lunderot/7-seg-array-clock/media/pcb-front.png

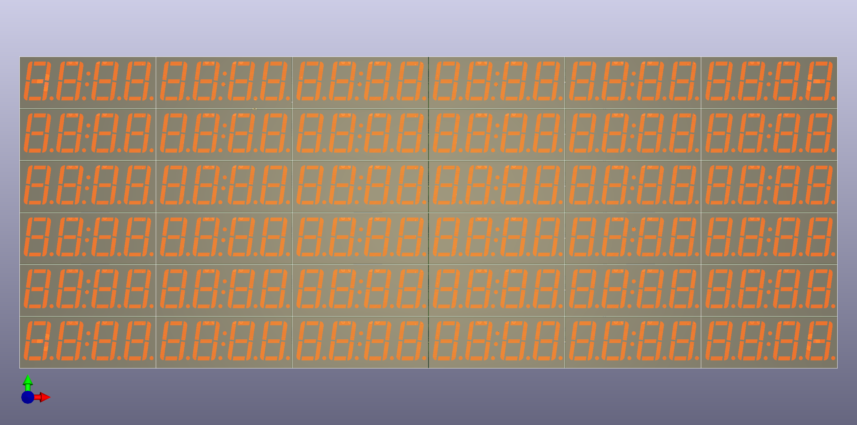
media/pcb-front.png
