lunderot/7-seg-array-clock/README.md

# 7 segment array clock
A clock made of 144 individual 7-segment displays. Uses a ESP8266 and MAX7219.

Finished clock
