lunderot/7-seg-array-clock/media/7-seg-4-digit.png

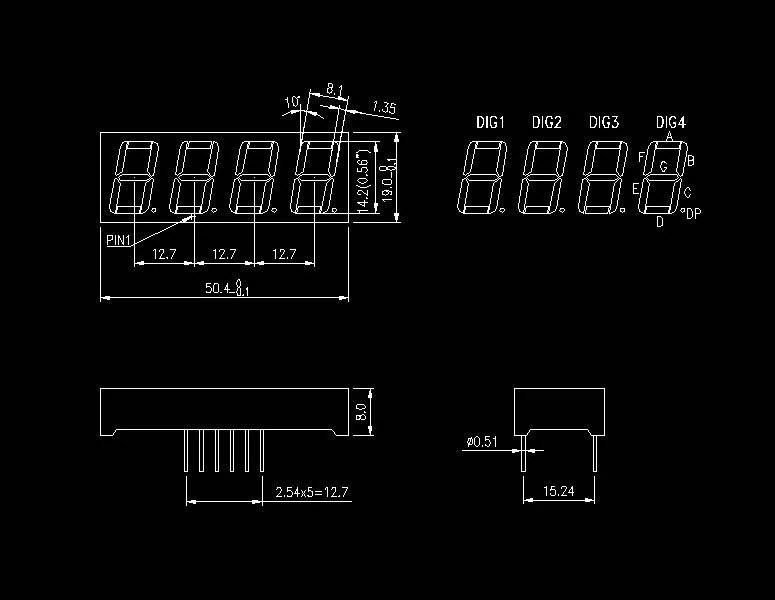
media/7-seg-4-digit.png
