lunderot/7-seg-array-clock/media/pcb-back.png

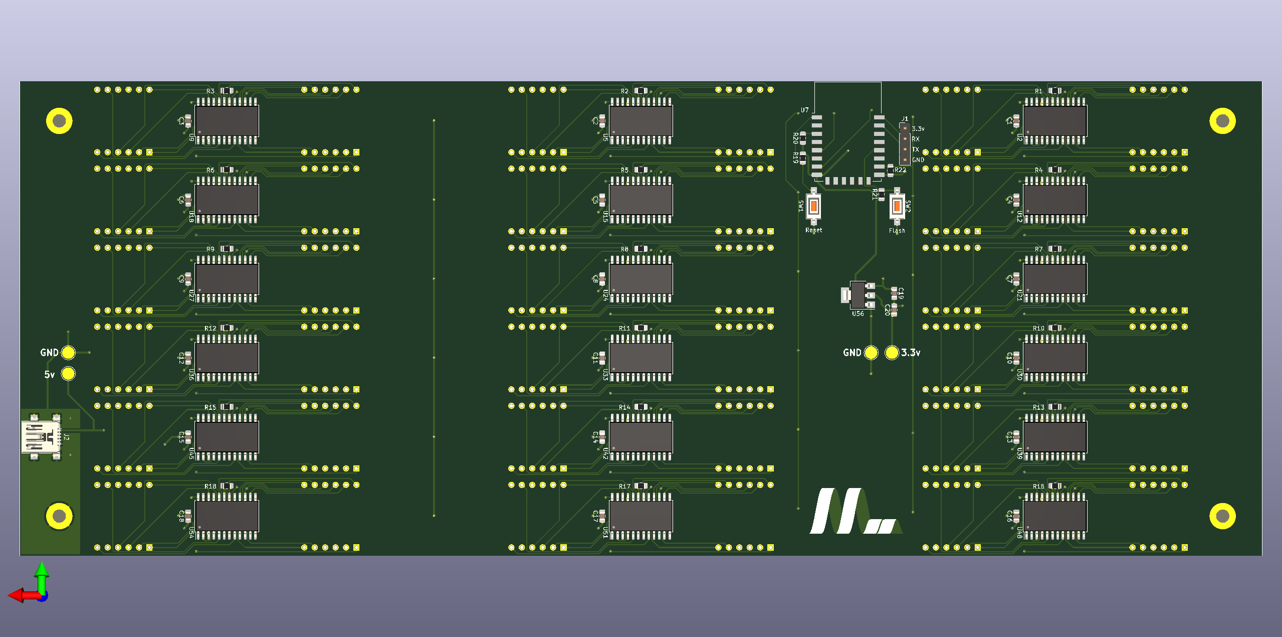
media/pcb-back.png
