lunderot/7-seg-array-clock/circuit/7-seg-array-clock.kicad_pcb

## KiCad design circuit/7-seg-array-clock.kicad_pcb (2020-04-03)

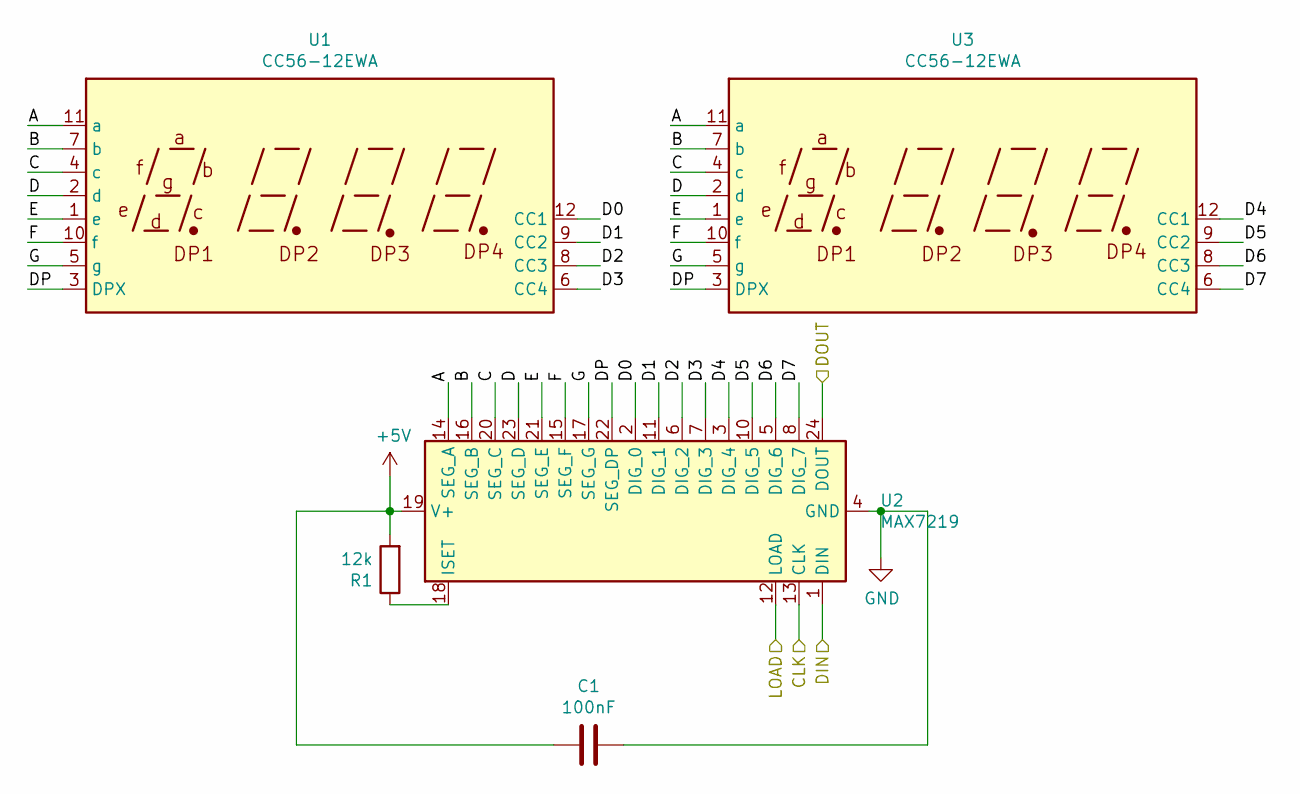
[picture p4: schematic 7-seg-8-dig.sch]

Parts:
C1: 100nF; C_0805_2012Metric_Pad1.15x1.40mm_HandSolder
R1: 12k; R_0805_2012Metric_Pad1.15x1.40mm_HandSolder
U1, U3: CC56-12EWA; 7seg
U2: MAX7219; SOIC-24W_7.5x15.4mm_P1.27mm

Connections:
+5V: C1.2, R1.2, U2.19 (V+); also elsewhere on the board
/display0/A: U1.11 (a), U2.14 (SEG_A), U3.11 (a)
/display0/B: U1.7 (b), U2.16 (SEG_B), U3.7 (b)
/display0/C: U1.4 (c), U2.20 (SEG_C), U3.4 (c)
/display0/D: U1.2 (d), U2.23 (SEG_D), U3.2 (d)
/display0/D0: U1.12 (CC1), U2.2 (DIG_0)
/display0/D1: U1.9 (CC2), U2.11 (DIG_1)
/display0/D2: U1.8 (CC3), U2.6 (DIG_2)
/display0/D3: U1.6 (CC4), U2.7 (DIG_3)
/display0/D4: U2.3 (DIG_4), U3.12 (CC1)
/display0/D5: U2.10 (DIG_5), U3.9 (CC2)
/display0/D6: U2.5 (DIG_6), U3.8 (CC3)
/display0/D7: U2.8 (DIG_7), U3.6 (CC4)
/display0/DIN: U2.1 (DIN); also elsewhere on the board
/display0/DP: U1.3 (DPX), U2.22 (SEG_DP), U3.3 (DPX)
/display0/E: U1.1 (e), U2.21 (SEG_E), U3.1 (e)
/display0/F: U1.10 (f), U2.15 (SEG_F), U3.10 (f)
/display0/G: U1.5 (g), U2.17 (SEG_G), U3.5 (g)
/display1/DIN: U2.24 (DOUT); also elsewhere on the board
CLK: U2.13 (CLK); also elsewhere on the board
GND: C1.1, U2.4 (GND), U2.9 (GND); also elsewhere on the board
LOAD: U2.12 (LOAD); also elsewhere on the board
unnamed: R1.1, U2.18 (ISET)

Parts of its further copies:
C2, C3, C4, C5, C6, C7, C8, C9, C10, C11, C12, C13, C14, C15, C16, C17, C18: 100nF; C_0805_2012Metric_Pad1.15x1.40mm_HandSolder
R2, R3, R4, R5, R6, R7, R8, R9, R10, R11, R12, R13, R14, R15, R16, R17, R18: 12k; R_0805_2012Metric_Pad1.15x1.40mm_HandSolder
U4, U6, U8, U10, U11, U13, U14, U16, U17, U19, U20, U22, U23, U25, U26, U28, U29, U31, U32, U34, U35, U37, U38, U40, U41, U43, U44, U46, U47, U49, U50, U52, U53, U55: CC56-12EWA; 7seg
U5, U9, U12, U15, U18, U21, U24, U27, U30, U33, U36, U39, U42, U45, U48, U51, U54: MAX7219; SOIC-24W_7.5x15.4mm_P1.27mm

Connections of its further copies:
+5V: C2.2, C3.2, C4.2, C5.2, C6.2, C7.2, C8.2, C9.2, C10.2, C11.2, C12.2, C13.2, C14.2, C15.2, C16.2, C17.2, C18.2, R2.2, R3.2, R4.2, R5.2, R6.2, R7.2, R8.2, R9.2, R10.2, R11.2, R12.2, R13.2, R14.2, R15.2, R16.2, R17.2, R18.2, U5.19 (V+), U9.19 (V+), U12.19 (V+), U15.19 (V+), U18.19 (V+), U21.19 (V+), U24.19 (V+), U27.19 (V+), U30.19 (V+), U33.19 (V+), U36.19 (V+), U39.19 (V+), U42.19 (V+), U45.19 (V+), U48.19 (V+), U51.19 (V+), U54.19 (V+); also elsewhere on the board
/display1/A: U4.11 (a), U5.14 (SEG_A), U6.11 (a)
/display1/B: U4.7 (b), U5.16 (SEG_B), U6.7 (b)
/display1/C: U4.4 (c), U5.20 (SEG_C), U6.4 (c)
/display1/D: U4.2 (d), U5.23 (SEG_D), U6.2 (d)
/display1/D0: U4.12 (CC1), U5.2 (DIG_0)
/display1/D1: U4.9 (CC2), U5.11 (DIG_1)
/display1/D2: U4.8 (CC3), U5.6 (DIG_2)
/display1/D3: U4.6 (CC4), U5.7 (DIG_3)
/display1/D4: U5.3 (DIG_4), U6.12 (CC1)
/display1/D5: U5.10 (DIG_5), U6.9 (CC2)
/display1/D6: U5.5 (DIG_6), U6.8 (CC3)
/display1/D7: U5.8 (DIG_7), U6.6 (CC4)
/display1/DIN: U5.1 (DIN); also elsewhere on the board
/display1/DP: U4.3 (DPX), U5.22 (SEG_DP), U6.3 (DPX)
/display1/E: U4.1 (e), U5.21 (SEG_E), U6.1 (e)
/display1/F: U4.10 (f), U5.15 (SEG_F), U6.10 (f)
/display1/G: U4.5 (g), U5.17 (SEG_G), U6.5 (g)
/display3/A: U8.11 (a), U9.14 (SEG_A), U10.11 (a)
/display3/B: U8.7 (b), U9.16 (SEG_B), U10.7 (b)
/display3/C: U8.4 (c), U9.20 (SEG_C), U10.4 (c)
/display3/D: U8.2 (d), U9.23 (SEG_D), U10.2 (d)
/display3/D0: U8.12 (CC1), U9.2 (DIG_0)
/display3/D1: U8.9 (CC2), U9.11 (DIG_1)
/display3/D2: U8.8 (CC3), U9.6 (DIG_2)
/display3/D3: U8.6 (CC4), U9.7 (DIG_3)
/display3/D4: U9.3 (DIG_4), U10.12 (CC1)
/display3/D5: U9.10 (DIG_5), U10.9 (CC2)
/display3/D6: U9.5 (DIG_6), U10.8 (CC3)
/display3/D7: U9.8 (DIG_7), U10.6 (CC4)
/display3/DIN: U5.24 (DOUT), U9.1 (DIN)
/display3/DP: U8.3 (DPX), U9.22 (SEG_DP), U10.3 (DPX)
/display3/E: U8.1 (e), U9.21 (SEG_E), U10.1 (e)
/display3/F: U8.10 (f), U9.15 (SEG_F), U10.10 (f)
/display3/G: U8.5 (g), U9.17 (SEG_G), U10.5 (g)
/display4/A: U11.11 (a), U12.14 (SEG_A), U13.11 (a)
/display4/B: U11.7 (b), U12.16 (SEG_B), U13.7 (b)
/display4/C: U11.4 (c), U12.20 (SEG_C), U13.4 (c)
/display4/D: U11.2 (d), U12.23 (SEG_D), U13.2 (d)
/display4/D0: U11.12 (CC1), U12.2 (DIG_0)
/display4/D1: U11.9 (CC2), U12.11 (DIG_1)
/display4/D2: U11.8 (CC3), U12.6 (DIG_2)
/display4/D3: U11.6 (CC4), U12.7 (DIG_3)
/display4/D4: U12.3 (DIG_4), U13.12 (CC1)
/display4/D5: U12.10 (DIG_5), U13.9 (CC2)
/display4/D6: U12.5 (DIG_6), U13.8 (CC3)
/display4/D7: U12.8 (DIG_7), U13.6 (CC4)
/display4/DIN: U9.24 (DOUT), U12.1 (DIN)
/display4/DP: U11.3 (DPX), U12.22 (SEG_DP), U13.3 (DPX)
/display4/E: U11.1 (e), U12.21 (SEG_E), U13.1 (e)
/display4/F: U11.10 (f), U12.15 (SEG_F), U13.10 (f)
/display4/G: U11.5 (g), U12.17 (SEG_G), U13.5 (g)
/display5/A: U14.11 (a), U15.14 (SEG_A), U16.11 (a)
/display5/B: U14.7 (b), U15.16 (SEG_B), U16.7 (b)
/display5/C: U14.4 (c), U15.20 (SEG_C), U16.4 (c)
/display5/D: U14.2 (d), U15.23 (SEG_D), U16.2 (d)
/display5/D0: U14.12 (CC1), U15.2 (DIG_0)
/display5/D1: U14.9 (CC2), U15.11 (DIG_1)
/display5/D2: U14.8 (CC3), U15.6 (DIG_2)
/display5/D3: U14.6 (CC4), U15.7 (DIG_3)
/display5/D4: U15.3 (DIG_4), U16.12 (CC1)
/display5/D5: U15.10 (DIG_5), U16.9 (CC2)
/display5/D6: U15.5 (DIG_6), U16.8 (CC3)
/display5/D7: U15.8 (DIG_7), U16.6 (CC4)
/display5/DIN: U12.24 (DOUT), U15.1 (DIN)
/display5/DP: U14.3 (DPX), U15.22 (SEG_DP), U16.3 (DPX)
/display5/E: U14.1 (e), U15.21 (SEG_E), U16.1 (e)
/display5/F: U14.10 (f), U15.15 (SEG_F), U16.10 (f)
/display5/G: U14.5 (g), U15.17 (SEG_G), U16.5 (g)
/display6/A: U17.11 (a), U18.14 (SEG_A), U19.11 (a)
/display6/B: U17.7 (b), U18.16 (SEG_B), U19.7 (b)
/display6/C: U17.4 (c), U18.20 (SEG_C), U19.4 (c)
/display6/D: U17.2 (d), U18.23 (SEG_D), U19.2 (d)
/display6/D0: U17.12 (CC1), U18.2 (DIG_0)
/display6/D1: U17.9 (CC2), U18.11 (DIG_1)
/display6/D2: U17.8 (CC3), U18.6 (DIG_2)
/display6/D3: U17.6 (CC4), U18.7 (DIG_3)
/display6/D4: U18.3 (DIG_4), U19.12 (CC1)
/display6/D5: U18.10 (DIG_5), U19.9 (CC2)
/display6/D6: U18.5 (DIG_6), U19.8 (CC3)
/display6/D7: U18.8 (DIG_7), U19.6 (CC4)
/display6/DIN: U15.24 (DOUT), U18.1 (DIN)
/display6/DP: U17.3 (DPX), U18.22 (SEG_DP), U19.3 (DPX)
/display6/E: U17.1 (e), U18.21 (SEG_E), U19.1 (e)
/display6/F: U17.10 (f), U18.15 (SEG_F), U19.10 (f)
/display6/G: U17.5 (g), U18.17 (SEG_G), U19.5 (g)
/display7/A: U20.11 (a), U21.14 (SEG_A), U22.11 (a)
/display7/B: U20.7 (b), U21.16 (SEG_B), U22.7 (b)
/display7/C: U20.4 (c), U21.20 (SEG_C), U22.4 (c)
/display7/D: U20.2 (d), U21.23 (SEG_D), U22.2 (d)
/display7/D0: U20.12 (CC1), U21.2 (DIG_0)
/display7/D1: U20.9 (CC2), U21.11 (DIG_1)
/display7/D2: U20.8 (CC3), U21.6 (DIG_2)
/display7/D3: U20.6 (CC4), U21.7 (DIG_3)
/display7/D4: U21.3 (DIG_4), U22.12 (CC1)
/display7/D5: U21.10 (DIG_5), U22.9 (CC2)
/display7/D6: U21.5 (DIG_6), U22.8 (CC3)
/display7/D7: U21.8 (DIG_7), U22.6 (CC4)
/display7/DIN: U18.24 (DOUT), U21.1 (DIN)
/display7/DP: U20.3 (DPX), U21.22 (SEG_DP), U22.3 (DPX)
/display7/E: U20.1 (e), U21.21 (SEG_E), U22.1 (e)
/display7/F: U20.10 (f), U21.15 (SEG_F), U22.10 (f)
/display7/G: U20.5 (g), U21.17 (SEG_G), U22.5 (g)
/display8/A: U23.11 (a), U24.14 (SEG_A), U25.11 (a)
/display8/B: U23.7 (b), U24.16 (SEG_B), U25.7 (b)
/display8/C: U23.4 (c), U24.20 (SEG_C), U25.4 (c)
/display8/D: U23.2 (d), U24.23 (SEG_D), U25.2 (d)
/display8/D0: U23.12 (CC1), U24.2 (DIG_0)
/display8/D1: U23.9 (CC2), U24.11 (DIG_1)
/display8/D2: U23.8 (CC3), U24.6 (DIG_2)
/display8/D3: U23.6 (CC4), U24.7 (DIG_3)
/display8/D4: U24.3 (DIG_4), U25.12 (CC1)
/display8/D5: U24.10 (DIG_5), U25.9 (CC2)
/display8/D6: U24.5 (DIG_6), U25.8 (CC3)
/display8/D7: U24.8 (DIG_7), U25.6 (CC4)
/display8/DIN: U21.24 (DOUT), U24.1 (DIN)
/display8/DP: U23.3 (DPX), U24.22 (SEG_DP), U25.3 (DPX)
/display8/E: U23.1 (e), U24.21 (SEG_E), U25.1 (e)
/display8/F: U23.10 (f), U24.15 (SEG_F), U25.10 (f)
/display8/G: U23.5 (g), U24.17 (SEG_G), U25.5 (g)
/display9/A: U26.11 (a), U27.14 (SEG_A), U28.11 (a)
/display9/B: U26.7 (b), U27.16 (SEG_B), U28.7 (b)
/display9/C: U26.4 (c), U27.20 (SEG_C), U28.4 (c)
/display9/D: U26.2 (d), U27.23 (SEG_D), U28.2 (d)
/display9/D0: U26.12 (CC1), U27.2 (DIG_0)
/display9/D1: U26.9 (CC2), U27.11 (DIG_1)
/display9/D2: U26.8 (CC3), U27.6 (DIG_2)
/display9/D3: U26.6 (CC4), U27.7 (DIG_3)
/display9/D4: U27.3 (DIG_4), U28.12 (CC1)
/display9/D5: U27.10 (DIG_5), U28.9 (CC2)
/display9/D6: U27.5 (DIG_6), U28.8 (CC3)
/display9/D7: U27.8 (DIG_7), U28.6 (CC4)
/display9/DIN: U24.24 (DOUT), U27.1 (DIN)
/display9/DP: U26.3 (DPX), U27.22 (SEG_DP), U28.3 (DPX)
/display9/E: U26.1 (e), U27.21 (SEG_E), U28.1 (e)
/display9/F: U26.10 (f), U27.15 (SEG_F), U28.10 (f)
/display9/G: U26.5 (g), U27.17 (SEG_G), U28.5 (g)
/display10/A: U29.11 (a), U30.14 (SEG_A), U31.11 (a)
/display10/B: U29.7 (b), U30.16 (SEG_B), U31.7 (b)
/display10/C: U29.4 (c), U30.20 (SEG_C), U31.4 (c)
/display10/D: U29.2 (d), U30.23 (SEG_D), U31.2 (d)
/display10/D0: U29.12 (CC1), U30.2 (DIG_0)
/display10/D1: U29.9 (CC2), U30.11 (DIG_1)
/display10/D2: U29.8 (CC3), U30.6 (DIG_2)
/display10/D3: U29.6 (CC4), U30.7 (DIG_3)
/display10/D4: U30.3 (DIG_4), U31.12 (CC1)
/display10/D5: U30.10 (DIG_5), U31.9 (CC2)
/display10/D6: U30.5 (DIG_6), U31.8 (CC3)
/display10/D7: U30.8 (DIG_7), U31.6 (CC4)
/display10/DIN: U27.24 (DOUT), U30.1 (DIN)
/display10/DP: U29.3 (DPX), U30.22 (SEG_DP), U31.3 (DPX)
/display10/E: U29.1 (e), U30.21 (SEG_E), U31.1 (e)
/display10/F: U29.10 (f), U30.15 (SEG_F), U31.10 (f)
/display10/G: U29.5 (g), U30.17 (SEG_G), U31.5 (g)
/display11/A: U32.11 (a), U33.14 (SEG_A), U34.11 (a)
/display11/B: U32.7 (b), U33.16 (SEG_B), U34.7 (b)
/display11/C: U32.4 (c), U33.20 (SEG_C), U34.4 (c)
/display11/D: U32.2 (d), U33.23 (SEG_D), U34.2 (d)
/display11/D0: U32.12 (CC1), U33.2 (DIG_0)
/display11/D1: U32.9 (CC2), U33.11 (DIG_1)
/display11/D2: U32.8 (CC3), U33.6 (DIG_2)
/display11/D3: U32.6 (CC4), U33.7 (DIG_3)
/display11/D4: U33.3 (DIG_4), U34.12 (CC1)
/display11/D5: U33.10 (DIG_5), U34.9 (CC2)
/display11/D6: U33.5 (DIG_6), U34.8 (CC3)
/display11/D7: U33.8 (DIG_7), U34.6 (CC4)
/display11/DIN: U30.24 (DOUT), U33.1 (DIN)
/display11/DP: U32.3 (DPX), U33.22 (SEG_DP), U34.3 (DPX)
/display11/E: U32.1 (e), U33.21 (SEG_E), U34.1 (e)
/display11/F: U32.10 (f), U33.15 (SEG_F), U34.10 (f)
/display11/G: U32.5 (g), U33.17 (SEG_G), U34.5 (g)
/display12/A: U35.11 (a), U36.14 (SEG_A), U37.11 (a)
/display12/B: U35.7 (b), U36.16 (SEG_B), U37.7 (b)
/display12/C: U35.4 (c), U36.20 (SEG_C), U37.4 (c)
/display12/D: U35.2 (d), U36.23 (SEG_D), U37.2 (d)
/display12/D0: U35.12 (CC1), U36.2 (DIG_0)
/display12/D1: U35.9 (CC2), U36.11 (DIG_1)
/display12/D2: U35.8 (CC3), U36.6 (DIG_2)
/display12/D3: U35.6 (CC4), U36.7 (DIG_3)
/display12/D4: U36.3 (DIG_4), U37.12 (CC1)
/display12/D5: U36.10 (DIG_5), U37.9 (CC2)
/display12/D6: U36.5 (DIG_6), U37.8 (CC3)
/display12/D7: U36.8 (DIG_7), U37.6 (CC4)
/display12/DIN: U33.24 (DOUT), U36.1 (DIN)
/display12/DP: U35.3 (DPX), U36.22 (SEG_DP), U37.3 (DPX)
/display12/E: U35.1 (e), U36.21 (SEG_E), U37.1 (e)
/display12/F: U35.10 (f), U36.15 (SEG_F), U37.10 (f)
/display12/G: U35.5 (g), U36.17 (SEG_G), U37.5 (g)
/display13/A: U38.11 (a), U39.14 (SEG_A), U40.11 (a)
/display13/B: U38.7 (b), U39.16 (SEG_B), U40.7 (b)
/display13/C: U38.4 (c), U39.20 (SEG_C), U40.4 (c)
/display13/D: U38.2 (d), U39.23 (SEG_D), U40.2 (d)
/display13/D0: U38.12 (CC1), U39.2 (DIG_0)
/display13/D1: U38.9 (CC2), U39.11 (DIG_1)
/display13/D2: U38.8 (CC3), U39.6 (DIG_2)
/display13/D3: U38.6 (CC4), U39.7 (DIG_3)
/display13/D4: U39.3 (DIG_4), U40.12 (CC1)
/display13/D5: U39.10 (DIG_5), U40.9 (CC2)
/display13/D6: U39.5 (DIG_6), U40.8 (CC3)
/display13/D7: U39.8 (DIG_7), U40.6 (CC4)
/display13/DIN: U36.24 (DOUT), U39.1 (DIN)
/display13/DP: U38.3 (DPX), U39.22 (SEG_DP), U40.3 (DPX)
/display13/E: U38.1 (e), U39.21 (SEG_E), U40.1 (e)
/display13/F: U38.10 (f), U39.15 (SEG_F), U40.10 (f)
/display13/G: U38.5 (g), U39.17 (SEG_G), U40.5 (g)
/display14/A: U41.11 (a), U42.14 (SEG_A), U43.11 (a)
/display14/B: U41.7 (b), U42.16 (SEG_B), U43.7 (b)
/display14/C: U41.4 (c), U42.20 (SEG_C), U43.4 (c)
/display14/D: U41.2 (d), U42.23 (SEG_D), U43.2 (d)
/display14/D0: U41.12 (CC1), U42.2 (DIG_0)
/display14/D1: U41.9 (CC2), U42.11 (DIG_1)
/display14/D2: U41.8 (CC3), U42.6 (DIG_2)
/display14/D3: U41.6 (CC4), U42.7 (DIG_3)
/display14/D4: U42.3 (DIG_4), U43.12 (CC1)
/display14/D5: U42.10 (DIG_5), U43.9 (CC2)
/display14/D6: U42.5 (DIG_6), U43.8 (CC3)
/display14/D7: U42.8 (DIG_7), U43.6 (CC4)
/display14/DIN: U39.24 (DOUT), U42.1 (DIN)
/display14/DP: U41.3 (DPX), U42.22 (SEG_DP), U43.3 (DPX)
/display14/E: U41.1 (e), U42.21 (SEG_E), U43.1 (e)
/display14/F: U41.10 (f), U42.15 (SEG_F), U43.10 (f)
/display14/G: U41.5 (g), U42.17 (SEG_G), U43.5 (g)
/display15/A: U44.11 (a), U45.14 (SEG_A), U46.11 (a)
/display15/B: U44.7 (b), U45.16 (SEG_B), U46.7 (b)
/display15/C: U44.4 (c), U45.20 (SEG_C), U46.4 (c)
/display15/D: U44.2 (d), U45.23 (SEG_D), U46.2 (d)
/display15/D0: U44.12 (CC1), U45.2 (DIG_0)
/display15/D1: U44.9 (CC2), U45.11 (DIG_1)
/display15/D2: U44.8 (CC3), U45.6 (DIG_2)
/display15/D3: U44.6 (CC4), U45.7 (DIG_3)
/display15/D4: U45.3 (DIG_4), U46.12 (CC1)
/display15/D5: U45.10 (DIG_5), U46.9 (CC2)
/display15/D6: U45.5 (DIG_6), U46.8 (CC3)
/display15/D7: U45.8 (DIG_7), U46.6 (CC4)
/display15/DIN: U42.24 (DOUT), U45.1 (DIN)
/display15/DP: U44.3 (DPX), U45.22 (SEG_DP), U46.3 (DPX)
/display15/E: U44.1 (e), U45.21 (SEG_E), U46.1 (e)
/display15/F: U44.10 (f), U45.15 (SEG_F), U46.10 (f)
/display15/G: U44.5 (g), U45.17 (SEG_G), U46.5 (g)
/display16/A: U47.11 (a), U48.14 (SEG_A), U49.11 (a)
/display16/B: U47.7 (b), U48.16 (SEG_B), U49.7 (b)
/display16/C: U47.4 (c), U48.20 (SEG_C), U49.4 (c)
/display16/D: U47.2 (d), U48.23 (SEG_D), U49.2 (d)
/display16/D0: U47.12 (CC1), U48.2 (DIG_0)
/display16/D1: U47.9 (CC2), U48.11 (DIG_1)
/display16/D2: U47.8 (CC3), U48.6 (DIG_2)
/display16/D3: U47.6 (CC4), U48.7 (DIG_3)
/display16/D4: U48.3 (DIG_4), U49.12 (CC1)
/display16/D5: U48.10 (DIG_5), U49.9 (CC2)
/display16/D6: U48.5 (DIG_6), U49.8 (CC3)
/display16/D7: U48.8 (DIG_7), U49.6 (CC4)
/display16/DIN: U45.24 (DOUT), U48.1 (DIN)
/display16/DP: U47.3 (DPX), U48.22 (SEG_DP), U49.3 (DPX)
/display16/E: U47.1 (e), U48.21 (SEG_E), U49.1 (e)
/display16/F: U47.10 (f), U48.15 (SEG_F), U49.10 (f)
/display16/G: U47.5 (g), U48.17 (SEG_G), U49.5 (g)
/display17/A: U50.11 (a), U51.14 (SEG_A), U52.11 (a)
/display17/B: U50.7 (b), U51.16 (SEG_B), U52.7 (b)
/display17/C: U50.4 (c), U51.20 (SEG_C), U52.4 (c)
/display17/D: U50.2 (d), U51.23 (SEG_D), U52.2 (d)
/display17/D0: U50.12 (CC1), U51.2 (DIG_0)
/display17/D1: U50.9 (CC2), U51.11 (DIG_1)
/display17/D2: U50.8 (CC3), U51.6 (DIG_2)
/display17/D3: U50.6 (CC4), U51.7 (DIG_3)
/display17/D4: U51.3 (DIG_4), U52.12 (CC1)
/display17/D5: U51.10 (DIG_5), U52.9 (CC2)
/display17/D6: U51.5 (DIG_6), U52.8 (CC3)
/display17/D7: U51.8 (DIG_7), U52.6 (CC4)
/display17/DIN: U48.24 (DOUT), U51.1 (DIN)
/display17/DP: U50.3 (DPX), U51.22 (SEG_DP), U52.3 (DPX)
/display17/E: U50.1 (e), U51.21 (SEG_E), U52.1 (e)
/display17/F: U50.10 (f), U51.15 (SEG_F), U52.10 (f)
/display17/G: U50.5 (g), U51.17 (SEG_G), U52.5 (g)
/display18/A: U53.11 (a), U54.14 (SEG_A), U55.11 (a)
/display18/B: U53.7 (b), U54.16 (SEG_B), U55.7 (b)
/display18/C: U53.4 (c), U54.20 (SEG_C), U55.4 (c)
/display18/D: U53.2 (d), U54.23 (SEG_D), U55.2 (d)
/display18/D0: U53.12 (CC1), U54.2 (DIG_0)
/display18/D1: U53.9 (CC2), U54.11 (DIG_1)
/display18/D2: U53.8 (CC3), U54.6 (DIG_2)
/display18/D3: U53.6 (CC4), U54.7 (DIG_3)
/display18/D4: U54.3 (DIG_4), U55.12 (CC1)
/display18/D5: U54.10 (DIG_5), U55.9 (CC2)
/display18/D6: U54.5 (DIG_6), U55.8 (CC3)
/display18/D7: U54.8 (DIG_7), U55.6 (CC4)
/display18/DIN: U51.24 (DOUT), U54.1 (DIN)
/display18/DOUT: U54.24 (DOUT)
/display18/DP: U53.3 (DPX), U54.22 (SEG_DP), U55.3 (DPX)
/display18/E: U53.1 (e), U54.21 (SEG_E), U55.1 (e)
/display18/F: U53.10 (f), U54.15 (SEG_F), U55.10 (f)
/display18/G: U53.5 (g), U54.17 (SEG_G), U55.5 (g)
CLK: U5.13 (CLK), U9.13 (CLK), U12.13 (CLK), U15.13 (CLK), U18.13 (CLK), U21.13 (CLK), U24.13 (CLK), U27.13 (CLK), U30.13 (CLK), U33.13 (CLK), U36.13 (CLK), U39.13 (CLK), U42.13 (CLK), U45.13 (CLK), U48.13 (CLK), U51.13 (CLK), U54.13 (CLK); also elsewhere on the board
GND: C2.1, C3.1, C4.1, C5.1, C6.1, C7.1, C8.1, C9.1, C10.1, C11.1, C12.1, C13.1, C14.1, C15.1, C16.1, C17.1, C18.1, U5.4 (GND), U5.9 (GND), U9.4 (GND), U9.9 (GND), U12.4 (GND), U12.9 (GND), U15.4 (GND), U15.9 (GND), U18.4 (GND), U18.9 (GND), U21.4 (GND), U21.9 (GND), U24.4 (GND), U24.9 (GND), U27.4 (GND), U27.9 (GND), U30.4 (GND), U30.9 (GND), U33.4 (GND), U33.9 (GND), U36.4 (GND), U36.9 (GND), U39.4 (GND), U39.9 (GND), U42.4 (GND), U42.9 (GND), U45.4 (GND), U45.9 (GND), U48.4 (GND), U48.9 (GND), U51.4 (GND), U51.9 (GND), U54.4 (GND), U54.9 (GND); also elsewhere on the board
LOAD: U5.12 (LOAD), U9.12 (LOAD), U12.12 (LOAD), U15.12 (LOAD), U18.12 (LOAD), U21.12 (LOAD), U24.12 (LOAD), U27.12 (LOAD), U30.12 (LOAD), U33.12 (LOAD), U36.12 (LOAD), U39.12 (LOAD), U42.12 (LOAD), U45.12 (LOAD), U48.12 (LOAD), U51.12 (LOAD), U54.12 (LOAD); also elsewhere on the board
unnamed: R2.1, U5.18 (ISET)
unnamed: R3.1, U9.18 (ISET)
unnamed: R4.1, U12.18 (ISET)
unnamed: R5.1, U15.18 (ISET)
unnamed: R6.1, U18.18 (ISET)
unnamed: R7.1, U21.18 (ISET)
unnamed: R8.1, U24.18 (ISET)
unnamed: R9.1, U27.18 (ISET)
unnamed: R10.1, U30.18 (ISET)
unnamed: R11.1, U33.18 (ISET)
unnamed: R12.1, U36.18 (ISET)
unnamed: R13.1, U39.18 (ISET)
unnamed: R14.1, U42.18 (ISET)
unnamed: R15.1, U45.18 (ISET)
unnamed: R16.1, U48.18 (ISET)
unnamed: R17.1, U51.18 (ISET)
unnamed: R18.1, U54.18 (ISET)

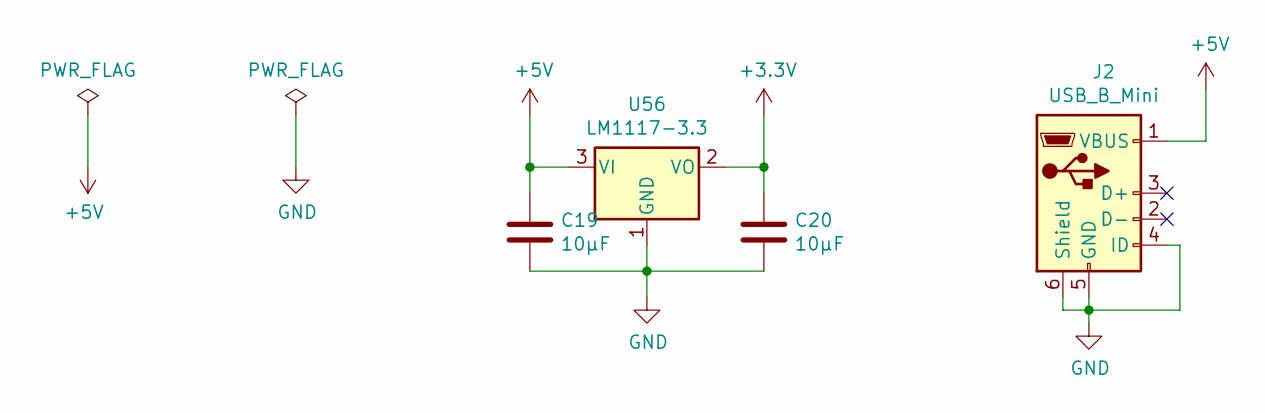
[picture p5: schematic power.sch]

Parts:
C19, C20: 10µF; C_0805_2012Metric_Pad1.15x1.40mm_HandSolder
J2: USB_B_Mini; USB_Mini-B_Lumberg_2486_01_Horizontal
U56: LM1117-3.3; SOT-223-3_TabPin2

Connections:
+3V3: C20.1, U56.2 (VO); also elsewhere on the board
+5V: C19.1, J2.1 (VBUS), U56.3 (VI); also elsewhere on the board
GND: C19.2, C20.2, J2.4 (ID), J2.5 (GND), J2.6 (Shield), U56.1 (GND); also elsewhere on the board

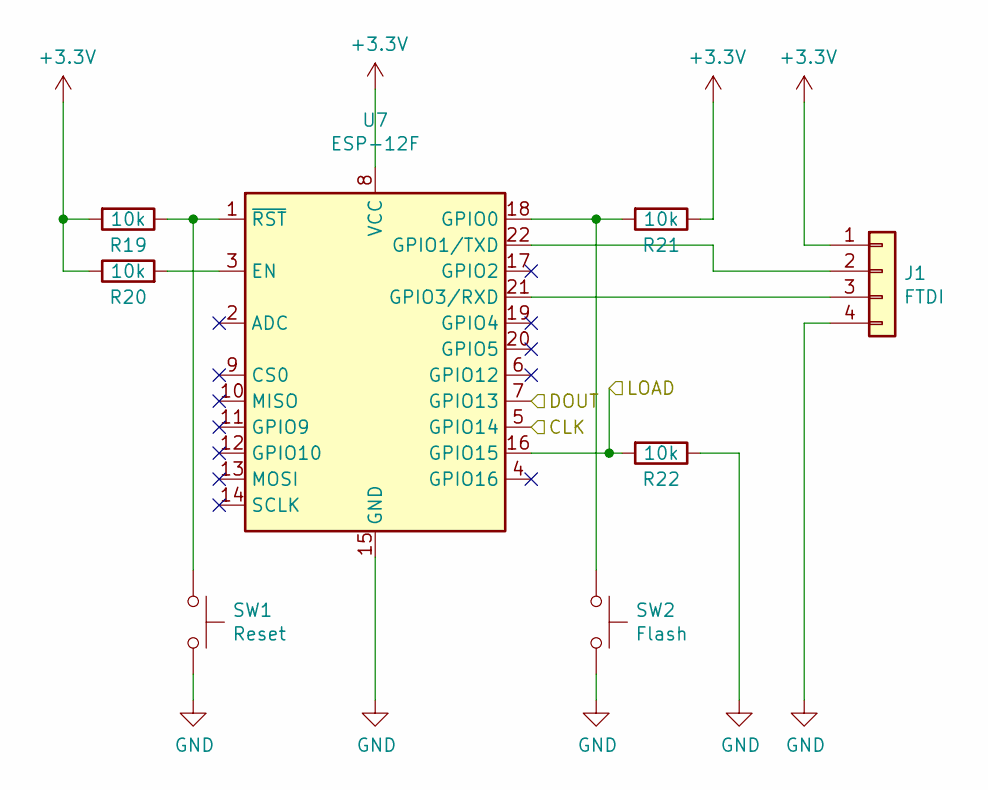
[picture p6: schematic controller.sch]

Parts:
J1: FTDI; PinHeader_1x04_P2.54mm_Vertical
R19, R20, R21, R22: 10k; R_0805_2012Metric_Pad1.15x1.40mm_HandSolder
SW1: Reset; SW_SPST_CK_RS282G05A3
SW2: Flash; SW_SPST_CK_RS282G05A3
U7: ESP-12F; ESP-12E

Connections:
+3V3: J1.1, R19.2, R20.1, R21.1, U7.8 (VCC); also elsewhere on the board
/display0/DIN: U7.7 (GPIO13); also elsewhere on the board
CLK: U7.5 (GPIO14); also elsewhere on the board
GND: J1.4, R22.1, SW1.2, SW2.2, U7.15 (GND); also elsewhere on the board
LOAD: R22.2, U7.16 (GPIO15); also elsewhere on the board
unnamed: J1.2, U7.22 (GPIO1/TXD)
unnamed: J1.3, U7.21 (GPIO3/RXD)
unnamed: R19.1, SW1.1, U7.1 (~RST)
unnamed: R20.2, U7.3 (EN)
unnamed: R21.2, SW2.1, U7.18 (GPIO0)

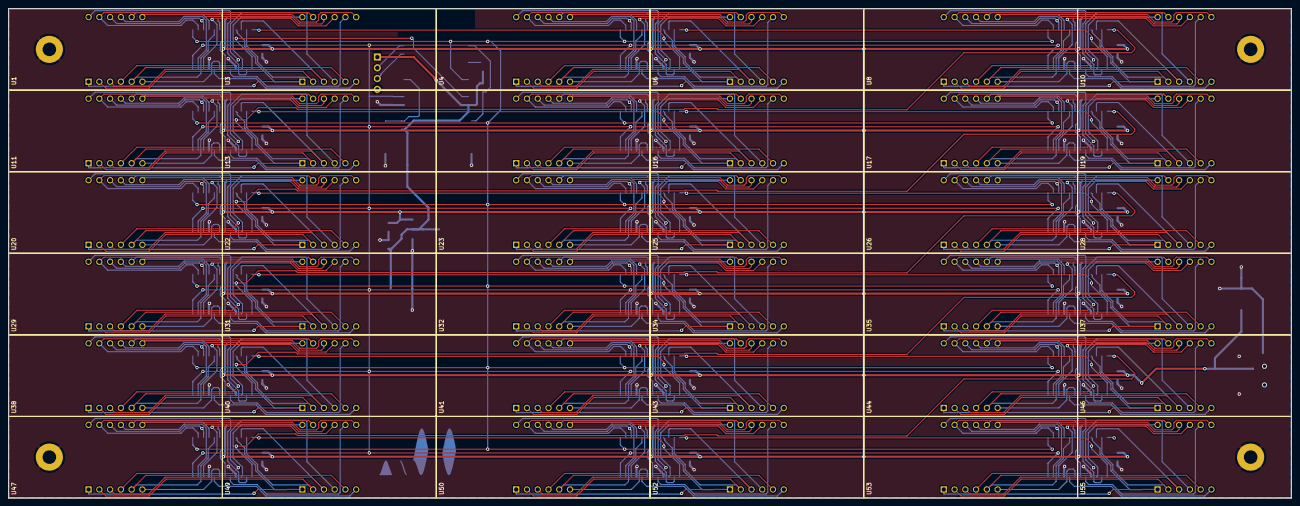
[picture p7: board 7-seg-array-clock.kicad_pcb from above]

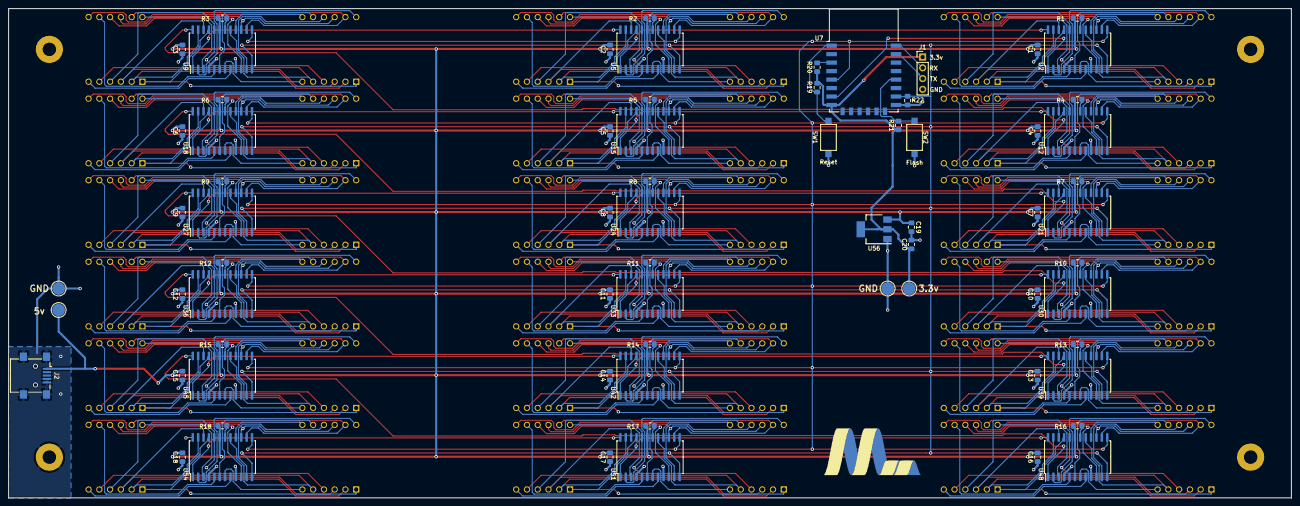
[picture p8: board 7-seg-array-clock.kicad_pcb from below]

Board: 2 copper layers, 302.6 x 115.4 mm, 102 parts (66 on the bottom side), 334 nets.
