lunderot/7-seg-array-clock/code/src/main.ino

#include <ESP8266WiFi.h>
#include <WiFiUdp.h>
#include <SPI.h>
#include <NTPClient.h>
#include <ESP8266WebServer.h>
#include <EEPROM.h>
#include <time.h>
#include "bigsegs.h"

#define NUM_CHIPS 18
#define NUM_DIGITS (NUM_CHIPS * 8)
#define DISPLAY_WIDTH 24
#define DISPLAY_HEIGHT 6

SPISettings spiSettings(5000000, MSBFIRST, SPI_MODE0);
WiFiUDP ntpUDP;
NTPClient timeClient(ntpUDP, "europe.pool.ntp.org");

uint8_t data[NUM_DIGITS] = {0};
int count = 0;

uint8_t pattern[] = {0x80,
					 0x9C, 0xBD, 0xFF, 0xFF, 0xFF, 0xFF, 0xFF, 0xFF, 0x9F, 0x9D, 0x0C, 0x00, 0x00, 0x00, 0x00, 0x00, 0x00, 0x00, 0x00, 0x00, 0x00, 0x00, 0x00, 0xFF, 0xFF, 0xFF, 0xFF, 0xFF, 0xFF, 0xFF, 0xFF, 0xFF, 0xFF, 0xFF, 0xFF, 0xFF, 0x9D, 0x00, 0x00, 0x00, 0x00, 0x00, 0x00, 0x00, 0x80, 0x9C, 0xBF, 0xFF, 0xFF, 0xFF, 0xFF, 0xFF, 0xFF, 0xFF, 0xFF, 0xFF, 0xFF, 0xFF, 0xFF, 0xFF, 0xFF, 0xFF, 0xFF, 0x9F, 0x9D, 0x9D, 0xBD, 0xFF, 0xFF, 0xFF, 0xFF, 0xFF, 0xFF, 0xFF, 0xFF, 0xFF, 0xFF, 0xFF, 0xFF, 0xFF, 0xFF, 0xFF, 0xFF, 0xFF, 0xFF, 0xFF, 0x7F, 0x63, 0x63, 0x63, 0x63, 0xF7, 0xFF, 0xFF, 0xFF, 0xFF, 0xFF, 0xFF, 0xFF, 0xFF, 0xFF, 0xFF, 0xFF, 0xFF, 0xFF, 0xFF, 0xFF, 0x7F, 0x62, 0x00, 0x00, 0x00, 0x00, 0x00, 0x00, 0x00, 0x00, 0x62, 0x63, 0x00, 0x60, 0x63, 0xF7, 0xFF, 0xFF, 0xFF, 0xFF, 0x7F, 0x67, 0x62, 0x00, 0x00, 0x00, 0x00, 0x00, 0x00, 0x00, 0x00, 0x00, 0x00, 0x00, 0x00, 0x00, 0x98,
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
					 0x80, 0x9C, 0xBD, 0xFF, 0xFF, 0xFF, 0xFF, 0xFF, 0xFF, 0x9F, 0x9C, 0x00, 0x00, 0x00, 0x00, 0x00, 0x00, 0x00, 0x00, 0x00, 0x00, 0x00, 0x00, 0xFF, 0xFF, 0xFF, 0xFF, 0xFF, 0xFF, 0xFF, 0xFF, 0xFF, 0xFF, 0xFF, 0xFF, 0xFF, 0xFF, 0x9C, 0x00, 0x00, 0x00, 0x00, 0x00, 0x00, 0x00, 0x80, 0x9C, 0xFF, 0xFF, 0xFF, 0xFF, 0xFF, 0xFF, 0xFF, 0xFF, 0xFF, 0xFF, 0xFF, 0xFF, 0xFF, 0xFF, 0xFF, 0xFF, 0xFF, 0x9D, 0x9D, 0x9D, 0xBD, 0xFF, 0xFF, 0xFF, 0xFF, 0xFF, 0xFF, 0xFF, 0xFF, 0xFF, 0xFF, 0xFF, 0xFF, 0xFF, 0xFF, 0xFF, 0xFF, 0xFF, 0xFF, 0xFF, 0x77, 0x63, 0x63, 0x63, 0x63, 0xFF, 0xFF, 0xFF, 0xF7, 0xFF, 0xFF, 0xFF, 0xFF, 0xFF, 0xFF, 0xFF, 0xFF, 0xFF, 0xFF, 0xFF, 0xFF, 0x7F, 0x42, 0x00, 0x00, 0x00, 0x00, 0x00, 0x00, 0x00, 0x00, 0x62, 0x00, 0x00, 0x62, 0x63, 0xFF, 0xFF, 0xFF, 0xFF, 0xFF, 0x7F, 0x63, 0x62, 0x00, 0x00, 0x00, 0x00, 0x00, 0x00, 0x00, 0x00, 0x00, 0x00, 0x00, 0x00};
#define NUM_FRAMES 30

ESP8266WebServer webServer(80);

struct wifi_data_t
{
	char ssid[128];
	char password[128];
	int offset;
} wifiData;

void sendAll(uint16_t command)
{
	SPI.beginTransaction(spiSettings);
	digitalWrite(SS, 0);
	for (size_t i = 0; i < NUM_CHIPS; i++)
	{
		SPI.transfer16(command);
	}
	digitalWrite(SS, 1);
	SPI.endTransaction();
}

void sendBuffer(uint8_t *buffer)
{
	for (size_t j = 0; j < 8; j++)
	{
		SPI.beginTransaction(spiSettings);
		digitalWrite(SS, 0);
		for (size_t i = 0; i < NUM_CHIPS; i++)
		{
			int index = ((NUM_DIGITS - 8 * i) - 8) + j;
			int dig = (j + 1) << 8;
			SPI.transfer16(dig | buffer[index]);
		}
		digitalWrite(SS, 1);
		SPI.endTransaction();
	}
}

void writeBigSeg(uint8_t *data, uint8_t *const segs, uint8_t digit, uint8_t offset, bool orFirst)
{
	for (size_t i = 0; i < 6; i++)
	{
		uint8_t *dst = data + i * DISPLAY_WIDTH + offset;
		uint8_t *src = bigsegs + 36 * digit + i * 6;
		if (orFirst)
		{
			*dst |= *src;
			memcpy(dst + 1, src + 1, 5);
		}
		else
		{
			memcpy(dst, src, 6);
		}
	}
}

void writeDots(uint8_t *data, bool state, uint8_t on, uint8_t off)
{
	data[(24 * 1 + 12)] = state ? on : off;
	data[(24 * 4 + 11)] = state ? on : off;
}

int isCEST(time_t timestamp)
{
	struct tm *timeinfo;
	timeinfo = localtime(&timestamp);

	int year = timeinfo->tm_year + 1900;
	int month = timeinfo->tm_mon + 1;
	int day = timeinfo->tm_mday;

	if (year >= 1996)
	{
		int lastSundayInMarch = 31 - (((5 * year) / 4 + 4) % 7);
		int lastSundayInOctober = 31 - (((5 * year) / 4 + 1) % 7);

		if ((month == 3 && day > lastSundayInMarch) || (month > 3 && month < 10) ||
			(month == 10 && day < lastSundayInOctober))
		{
			return 1;
		}
	}
	return 0;
}

void clockFunction()
{
	timeClient.update();
	int hour = timeClient.getHours();
	int minute = timeClient.getMinutes();
	if (hour == 0)
	{
		timeClient.setTimeOffset(3600 * (wifiData.offset + isCEST(timeClient.getEpochTime())));
	}

	writeBigSeg(data, bigsegs, hour / 10, 0, false);
	writeBigSeg(data, bigsegs, hour % 10, 5, true);
	writeBigSeg(data, bigsegs, minute / 10, 13, false);
	writeBigSeg(data, bigsegs, minute % 10, 18, true);
	writeDots(data, true, 0b00011101, 0b00000000);
	sendBuffer(data);
}

void patternFunction()
{
	if (++count % NUM_FRAMES == 0)
	{
		count = 0;
	}
	sendBuffer(pattern + (144 * count));
}

void handleRoot()
{
	webServer.send(200, "text/html", "<!doctypehtml><html lang=en><meta charset=UTF-8><form action=/p method=POST style=display:flex;flex-direction:column;width:50em><label for=ssid>SSID:</label> <input id=ssid name=ssid> <label for=password>Password:</label> <input id=password name=password> <label for=offset>Offset:</label> <input id=offset name=offset> <button>Apply</button></form>");
}

void handlePost()
{
	const String &ssid = webServer.arg("ssid");
	const String &password = webServer.arg("password");
	int offset = webServer.arg("offset").toInt();

	if (ssid.length() > 0)
	{
		ssid.toCharArray(wifiData.ssid, 128);
	}
	if (password.length() > 0)
	{
		password.toCharArray(wifiData.password, 128);
	}
	wifiData.offset = offset;
	EEPROM.put(0, wifiData);
	EEPROM.commit();

	webServer.send(200, "text/plain", "Success!\nRestarting...");
	delay(1000);
	ESP.restart();
}

void connectOrHost(const char *ssid, const char *password)
{
	WiFi.begin(ssid, password);
	int count = 0;
	while (WiFi.status() != WL_CONNECTED && count < 30)
	{
		delay(200);
		data[0] ^= 0b10000000;
		sendBuffer(data);
		count++;
	}
	data[0] = 0b00000000;
	if (count == 30)
	{
		WiFi.softAP("7 segment display config");
	}
	webServer.on("/", handleRoot);
	webServer.on("/p", handlePost);
	webServer.begin();
}

void setup()
{
	pinMode(SS, OUTPUT);
	digitalWrite(SS, 1);
	SPI.begin();
	SPI.setHwCs(false);

	sendAll(0x0F00); // Disable display test
	sendAll(0x0900); // Decode mode none
	sendAll(0x0B07); // Scan limit all
	sendAll(0x0A00); // Intensity 0
	sendAll(0x0C01); // Enable display

	EEPROM.begin(sizeof(wifi_data_t));
	EEPROM.get(0, wifiData);

	connectOrHost(wifiData.ssid, wifiData.password);

	timeClient.begin();
	timeClient.forceUpdate();
	timeClient.setTimeOffset(3600 * (wifiData.offset + isCEST(timeClient.getEpochTime())));
}

void loop()
{
	webServer.handleClient();
	clockFunction();
	delay(10);
}
