lunderot/7-seg-array-clock/code/include/bigsegs.h

uint8_t bigsegs[] = {
	0b00000000, 0b00000000, 0b00011000, 0b00111101, 0b01111111, 0b00011111,
	0b00000000, 0b00010000, 0b01111111, 0b01100111, 0b01111011, 0b01111111,
	0b00000000, 0b01111101, 0b01101111, 0b00000000, 0b00110000, 0b01001111,
	0b00000000, 0b01111111, 0b00000110, 0b00010000, 0b01111111, 0b00000110,
	0b00000000, 0b01111111, 0b00011111, 0b01111111, 0b01000111, 0b00000000,
	0b00000000, 0b01110011, 0b01111111, 0b01100111, 0b00000000, 0b00000000,

	0b00000000, 0b00000000, 0b00000000, 0b00010000, 0b01111111, 0b00011111,
	0b00000000, 0b00000000, 0b00000000, 0b01111111, 0b01111111, 0b00000110,
	0b00000000, 0b00000000, 0b00111101, 0b01111111, 0b01001111, 0b00000000,
	0b00000000, 0b00000000, 0b01111111, 0b01111111, 0b00000110, 0b00000000,
	0b00000000, 0b01111111, 0b01111111, 0b01000110, 0b00000000, 0b00000000,
	0b00100000, 0b01111111, 0b01111111, 0b00000000, 0b00000000, 0b00000000,

	0b00000000, 0b00000000, 0b00011000, 0b00111101, 0b01111111, 0b00011111,
	0b00000000, 0b00110000, 0b01111111, 0b01100010, 0b01111011, 0b01111111,
	0b00000000, 0b00000000, 0b00000000, 0b00111000, 0b01111111, 0b01000110,
	0b00000000, 0b00000000, 0b00111101, 0b01111111, 0b01000110, 0b00000000,
	0b00010000, 0b01111111, 0b01111111, 0b01000110, 0b00000000, 0b00000000,
	0b00100000, 0b01110011, 0b01111111, 0b01111111, 0b01100111, 0b00000000,

	0b00000000, 0b00000000, 0b00011000, 0b01111111, 0b01111111, 0b00011111,
	0b00000000, 0b00100000, 0b01111111, 0b01100010, 0b01111011, 0b01111111,
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
	0b00000000, 0b01111111, 0b01011111, 0b00011100, 0b01111111, 0b01001111,
	0b00000000, 0b01100000, 0b01111011, 0b01111111, 0b01111111, 0b00000010,
	0b00000000, 0b00011000, 0b01111111, 0b01100111, 0b00000000, 0b00000000,
	0b00100000, 0b01111111, 0b01000110, 0b00000000, 0b00000000, 0b00000000,
};
