lunderot/7-seg-array-clock/(commit log)

2020-02-01 Completed display circuit and made basic PCB layout
    [7-seg-8-dig.sch, 7-seg-array-clock.sch, controller.sch, power.sch]
2020-02-01 Added tracks to first display
    [7-seg-array-clock.kicad_pcb]
2020-02-02 Routed all displays
    [7-seg-array-clock.kicad_pcb]
2020-02-02 Updated display footprint
    [7-seg-8-dig.sch, 7-seg-array-clock.kicad_pcb]
2020-02-02 Added PCB screenshots
2020-02-02 Fixed display clearance issues
    [7-seg-array-clock.kicad_pcb]
2020-02-02 Updated footprint to the proper one
    [7-seg-array-clock.kicad_pcb]
2020-02-05 Added microcontroller circuit
    [7-seg-8-dig.sch, 7-seg-array-clock.sch, controller.sch, power.sch]
2020-02-09 Added controller to PCB
    [7-seg-array-clock.kicad_pcb]
2020-02-09 Finished PCB
    [7-seg-array-clock.kicad_pcb]
2020-02-23 Added mouting holes
    [7-seg-array-clock.kicad_pcb]
2020-02-23 Changed to use hardware spi
    [7-seg-array-clock.kicad_pcb, controller.sch]
2020-02-23 Added usb power connector
    [7-seg-8-dig.sch, 7-seg-array-clock.kicad_pcb, power.sch]
2020-03-21 Updated 7 segment footprint
    [7-seg-array-clock.kicad_pcb]
2020-03-21 Moved components
    [7-seg-array-clock.kicad_pcb]
2020-03-26 Routed first 8 digits
    [7-seg-array-clock.kicad_pcb]
2020-03-26 Copied tracks to other displays
    [7-seg-array-clock.kicad_pcb]
2020-03-29 Finished board with proper spacing
    [7-seg-array-clock.kicad_pcb]
2020-03-29 Updated 3d model to red segments
    [7-seg-array-clock.kicad_pcb]
2020-04-03 Added logo to PCB
    [7-seg-array-clock.kicad_pcb]
2020-04-03 Added voltage test pads
    [7-seg-array-clock.kicad_pcb]
2020-04-03 Updated PCB pictures
2020-07-18 Added CAD files
    [back-spacer.scad, screw-holder.scad]
2020-09-10 Added flat side to spacer
    [back-spacer.scad]
2022-08-18 Modified 3D-printed part to accept M2 nut
    [back-spacer.scad]
2023-05-23 Added time zone correction
    [main.ino]
2023-06-02 Fixed time zone correction
    [main.ino]
